craigyjp/MIDI-to-CV-with-aftertouch/midi2cvaftertouch.pdf

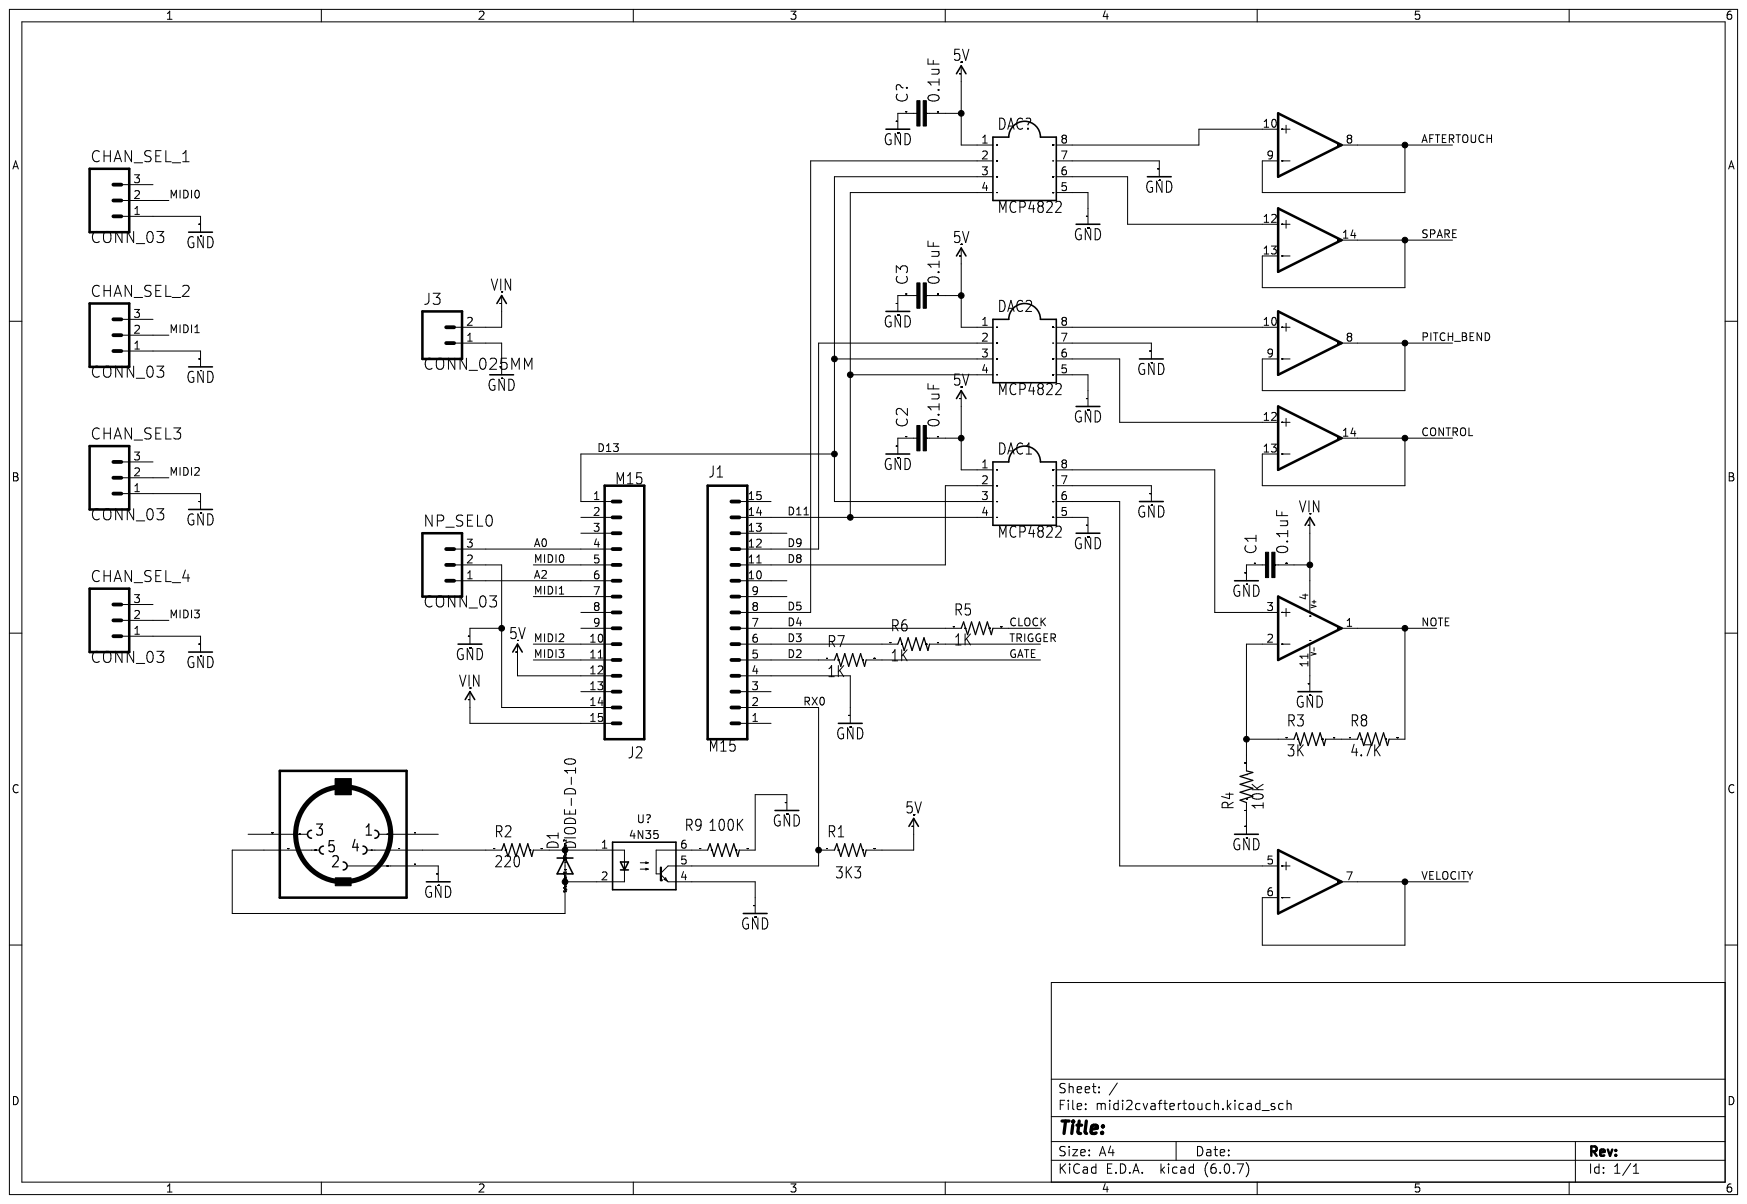
[picture p1: page 1]
