craigyjp/MIDI-to-CV-with-aftertouch/(commit log)

2022-10-31 Added sketch and schematic
2022-11-04 Fixed schematic inputs and outputs
    Moved the DAC3 and channel select pins away from the unused SPI pins
2022-11-04 Fixed pin assignments and Aftertouch data
    Aftertouch did not work as its only 2 bytes and not 3, reads correctly now
    [Elkyam_MIDI_CV_Aftertouch.ino]
